cracked-machine/CirrusDspPedal/README.md

CirrusDspPedal

Required Kicad Hardware library: https://github.com/cracked-machine/KicadLibrary
