cracked-machine/CirrusDspPedal/CirrusDspPedal/docs/Cirrus5343Packet.png

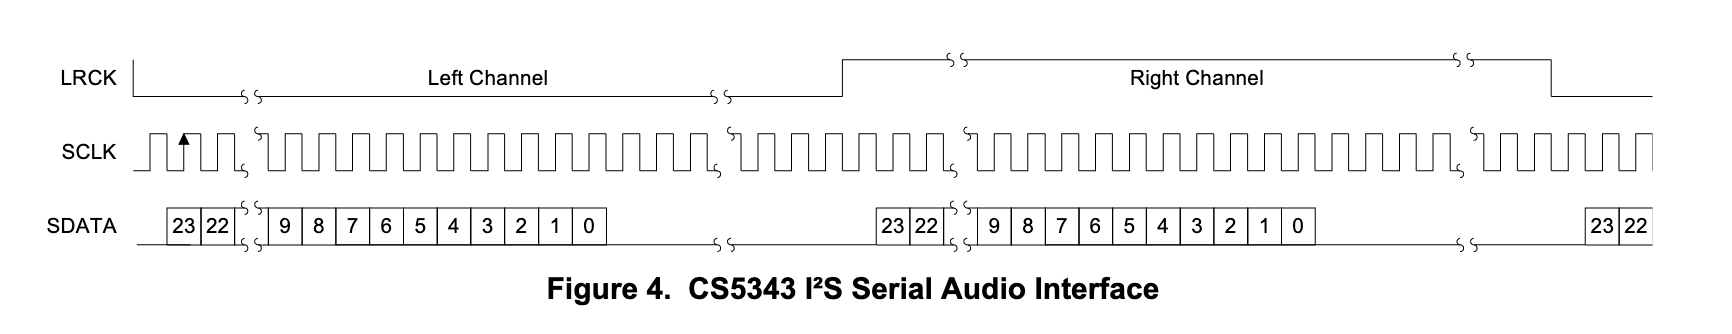
CirrusDspPedal/docs/Cirrus5343Packet.png
