cracked-machine/CirrusDspPedal/CirrusDspPedal/docs/DSPGuitarPedalF405_SystemBlockDiagram.png

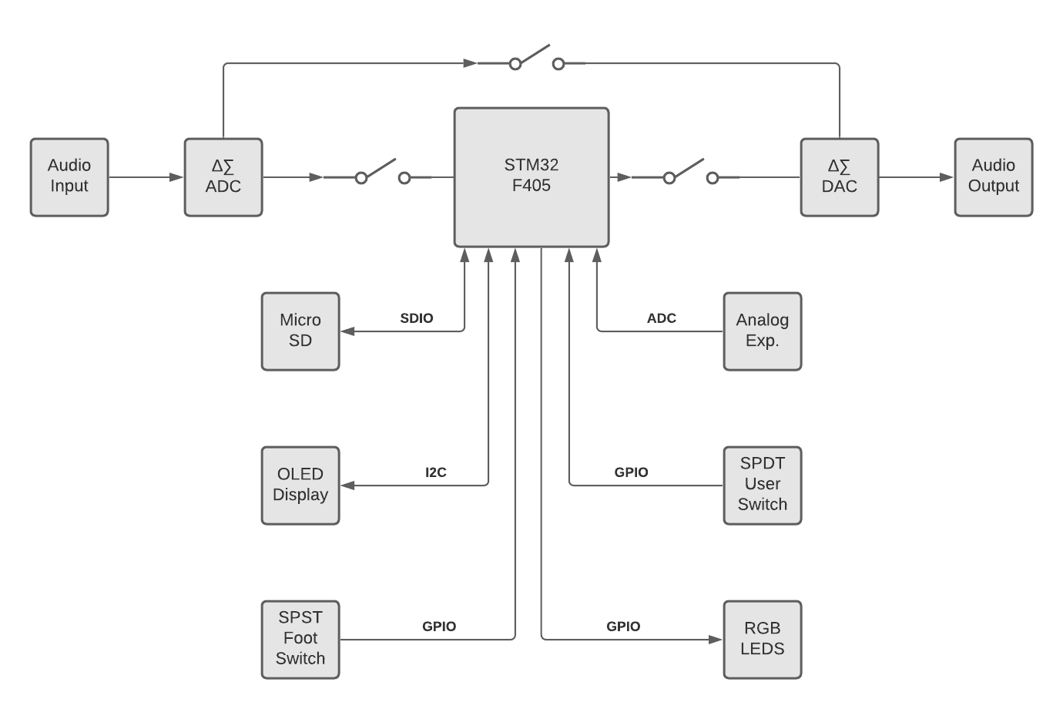
CirrusDspPedal/docs/DSPGuitarPedalF405_SystemBlockDiagram.png
