cracked-machine/CirrusDspPedal/CirrusDspPedal/docs/F405_I2S_24Bit.png

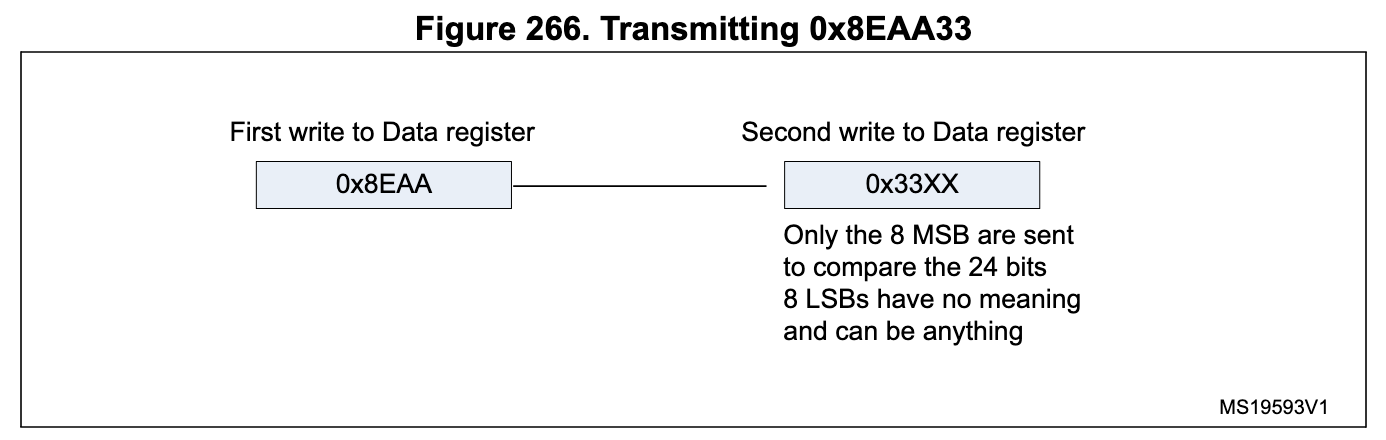
CirrusDspPedal/docs/F405_I2S_24Bit.png
