cracked-machine/CirrusDspPedal/CirrusDspPedal/docs/I2S_F32DoubleBuffer.png

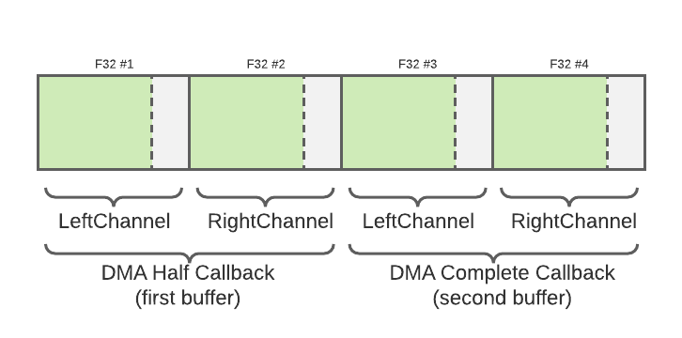
CirrusDspPedal/docs/I2S_F32DoubleBuffer.png
