cracked-machine/CirrusDspPedal/CirrusDspPedal/docs/I2S_PreparingRxData.png

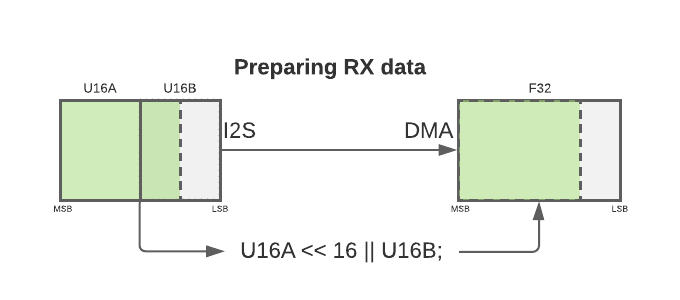
CirrusDspPedal/docs/I2S_PreparingRxData.png
