cracked-machine/CirrusDspPedal/CirrusDspPedal/docs/I2S_PreparingTxData.png

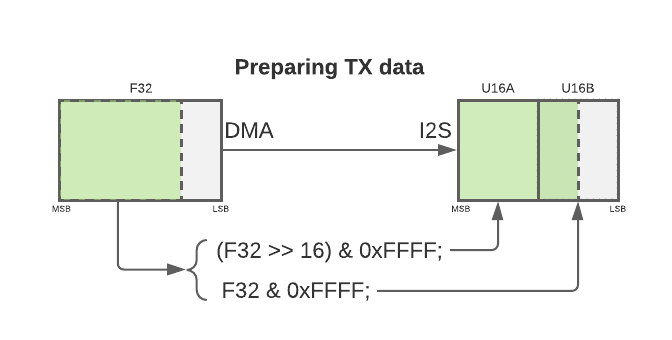
CirrusDspPedal/docs/I2S_PreparingTxData.png
