cracked-machine/CirrusDspPedal/CirrusDspPedal_FrontPanel/3d/M2012SS1W03.stp

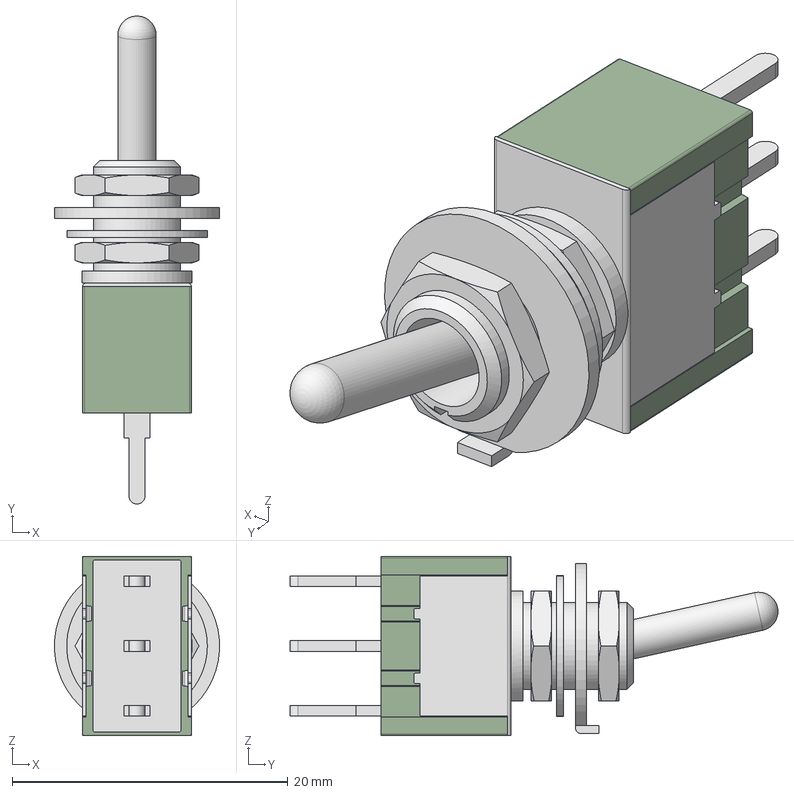
[picture p7: CAD file, 2020-11-12]
CirrusDspPedal_FrontPanel/3d/M2012SS1W03.stp
12.0 x 35.4 x 13.0 mm
_M20121SS1W03-switch
_M201S1M201-bushing
_AT513H x 2
_AT507H
_AT509
_M201203-terminals
_M20S-toggles
_M20S-caps
