cracked-machine/CirrusDspPedal/CirrusDspPedal_FrontPanel/3d/RK09D1130A1N/RK09D1130-F30.STEP

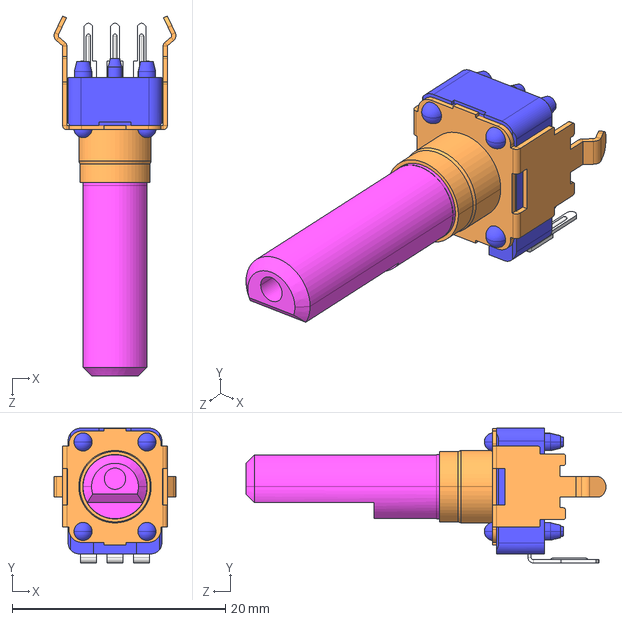
[picture p8: CAD file, 2020-10-19]
CirrusDspPedal_FrontPanel/3d/RK09D1130A1N/RK09D1130-F30.STEP
11.4 x 12.7 x 33.8 mm
