cracked-machine/CirrusDspPedal/CirrusDspPedal_FrontPanel/3d/rk09l1140a65/RK09L1140A65.STEP

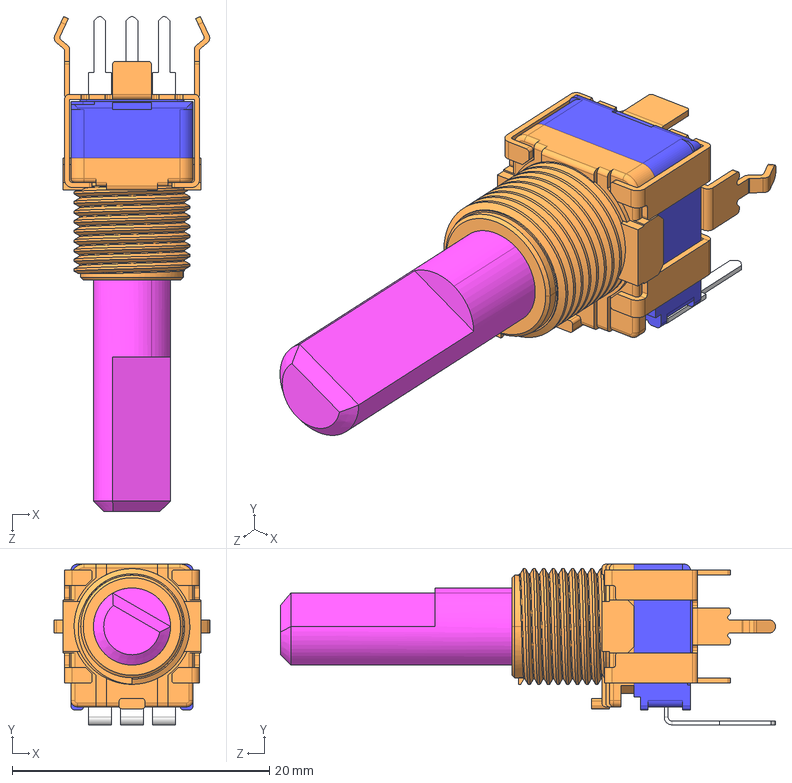
[picture p9: CAD file, 2020-10-19]
CirrusDspPedal_FrontPanel/3d/rk09l1140a65/RK09L1140A65.STEP
12.1 x 12.5 x 38.5 mm
