cracked-machine/CirrusDspPedal/CirrusDspPedal_FrontPanel/3d/pec11r-4x20f-sxxxx.stp

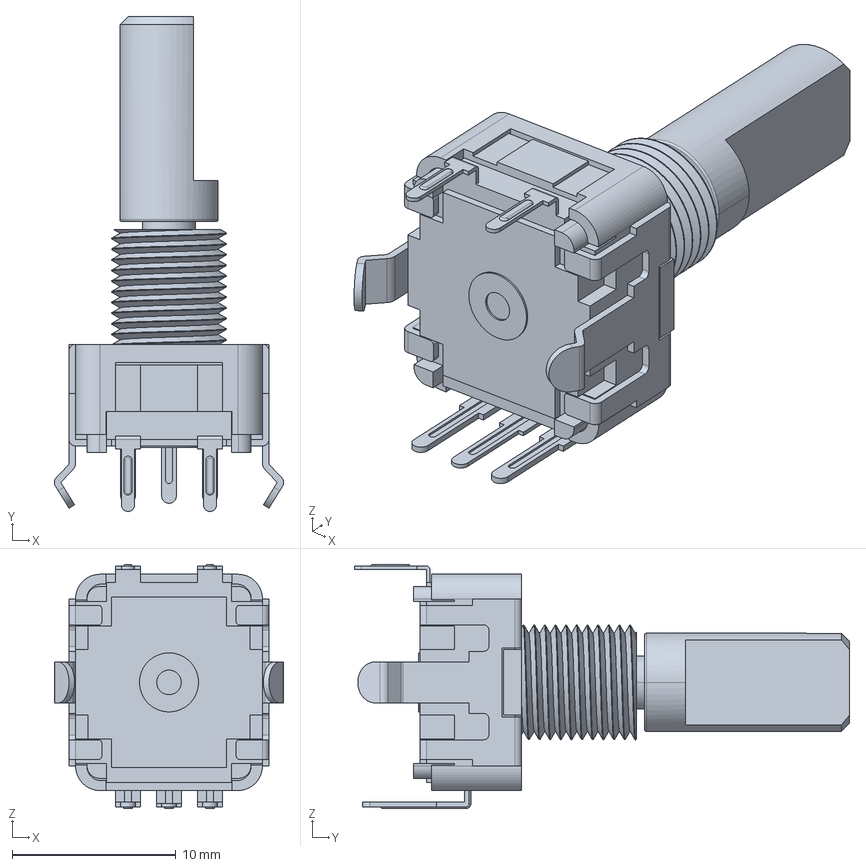
[picture p10: CAD file, 2020-11-12]
CirrusDspPedal_FrontPanel/3d/pec11r-4x20f-sxxxx.stp
14.0 x 30.2 x 14.9 mm
