cracked-machine/CirrusDspPedal/CirrusDspPedal_FrontPanel/3d/pec11r-4x30f-sxxxx.stp

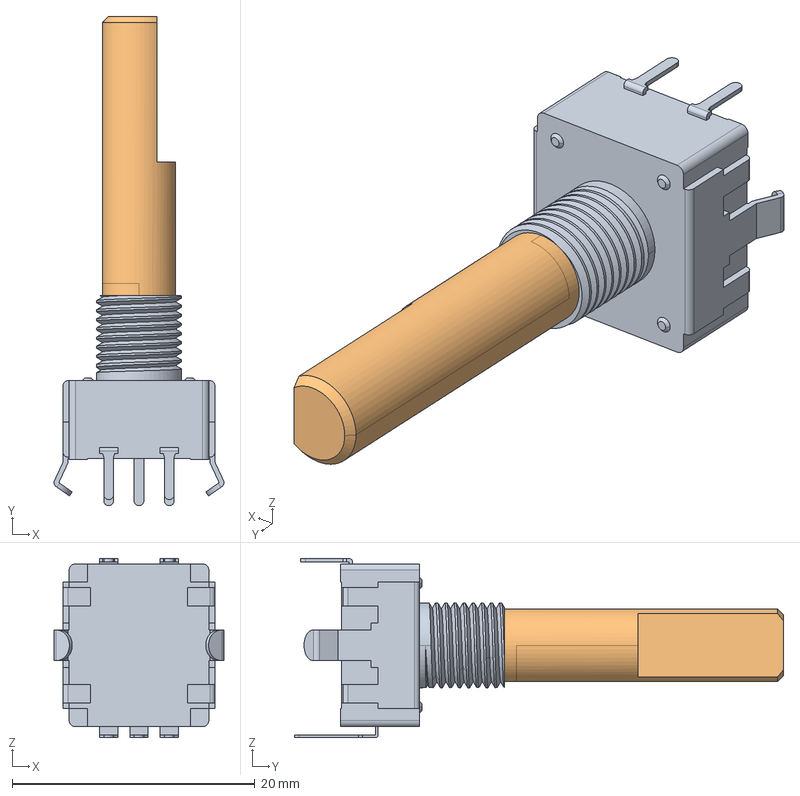
[picture p11: CAD file, 2020-11-12]
CirrusDspPedal_FrontPanel/3d/pec11r-4x30f-sxxxx.stp
14.0 x 40.3 x 14.8 mm
