cracked-machine/CirrusDspPedal/CirrusDspPedal_FrontPanel/3d/CUI_PJ-102A.STEP

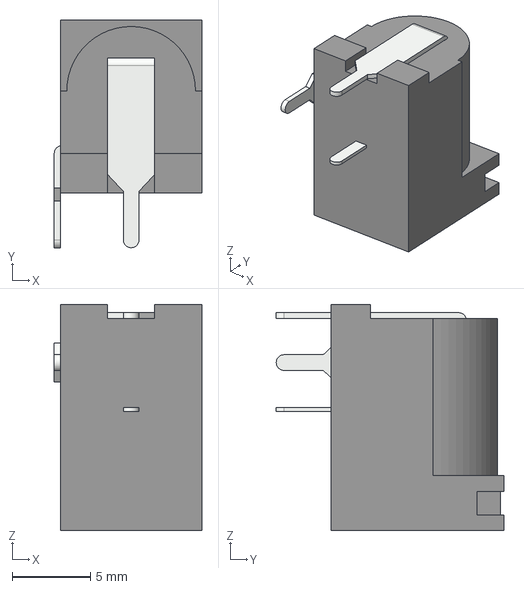
[picture p12: CAD file, 2020-11-12]
CirrusDspPedal_FrontPanel/3d/CUI_PJ-102A.STEP
9.40 x 14.5 x 14.4 mm
