cracked-machine/CirrusDspPedal/CirrusDspPedal_FrontPanel/3d/nrj4hf-2.stp

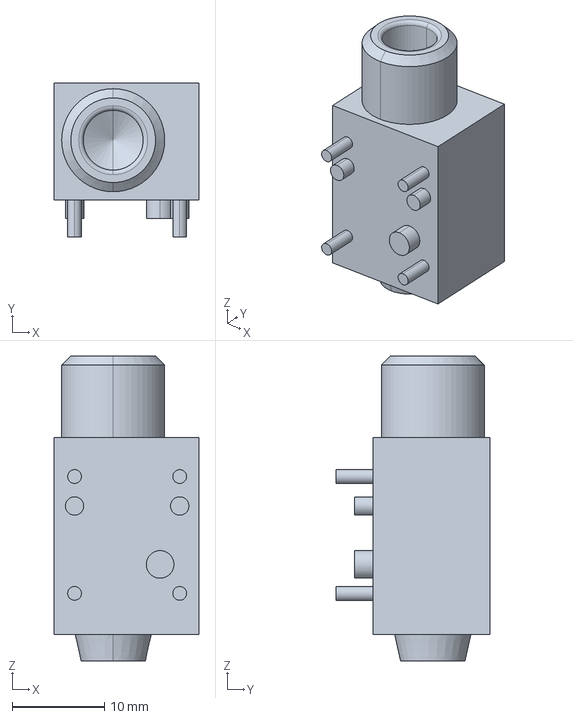
[picture p13: CAD file, 2020-10-19]
CirrusDspPedal_FrontPanel/3d/nrj4hf-2.stp
15.8 x 16.7 x 33.1 mm
