cracked-machine/CirrusDspPedal/CirrusDspPedal_FrontPanel/3d/c-3-643813-7-k-3d.stp

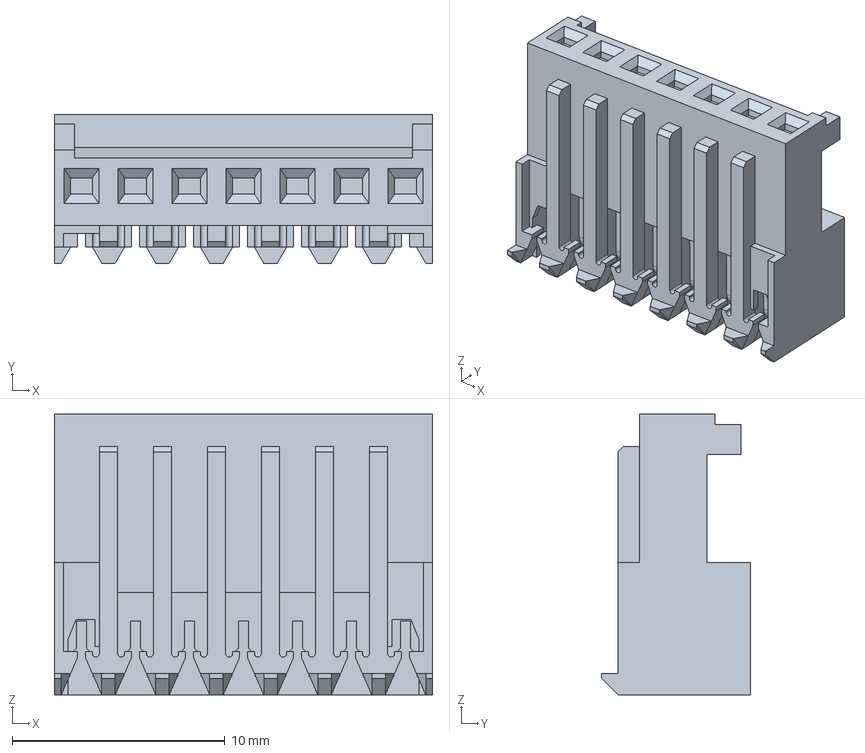
[picture p14: CAD file, 2020-10-18]
CirrusDspPedal_FrontPanel/3d/c-3-643813-7-k-3d.stp
17.8 x 6.98 x 13.2 mm
