cracked-machine/CirrusDspPedal/CirrusDspPedal_FrontPanel/3d/475710001.stp

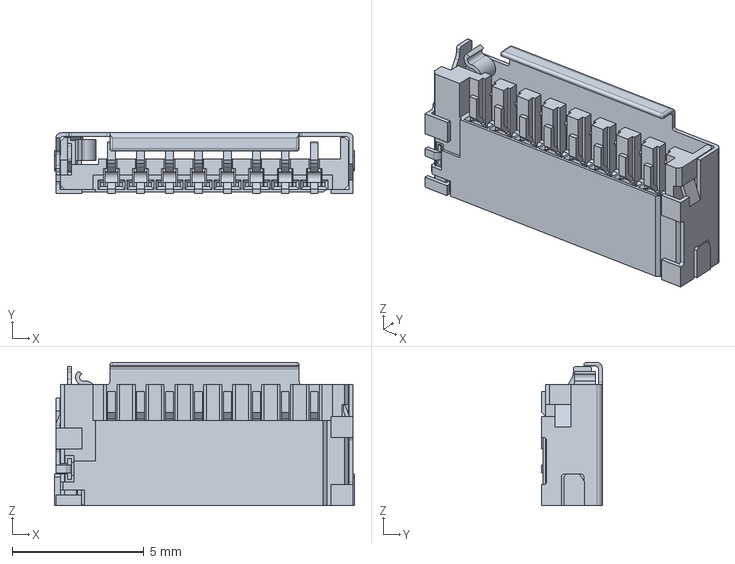
[picture p15: CAD file, 2020-11-10]
CirrusDspPedal_FrontPanel/3d/475710001.stp
11.4 x 2.30 x 5.45 mm
