cracked-machine/CirrusDspPedal/CirrusDspPedal_FrontPanel/ExpInput.sch

## KiCad design CirrusDspPedal_FrontPanel/ExpInput.sch (2020-10-12)

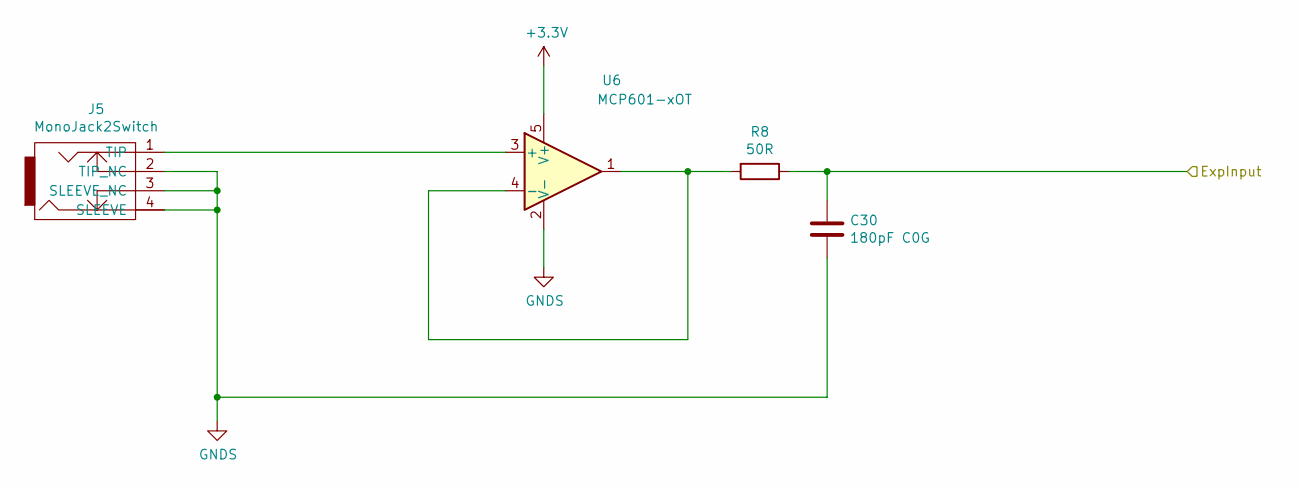
[picture p16: schematic ExpInput.sch]

Parts:
C30: 180pF C0G; C_0805_2012Metric_Pad1.15x1.40mm_HandSolder
J5: MonoJack2Switch; NRJxHx_NOTAB
R8: 50R; R_0805_2012Metric_Pad1.15x1.40mm_HandSolder
U6: MCP601-xOT; SOT-23-5

Connections:
+3.3V: U6.5 (V+)
ExpInput: C30.2, R8.1
GNDS: C30.1, J5.2 (TIP_NC), J5.3 (SLEEVE_NC), J5.4 (SLEEVE), U6.2 (V-)
unnamed: J5.1 (TIP), U6.3 (+)
unnamed: R8.2, U6.1, U6.4 (-)
