cracked-machine/CirrusDspPedal/CirrusDspPedal_FrontPanel/ExtInput.sch

## KiCad design CirrusDspPedal_FrontPanel/ExtInput.sch (2020-11-10)

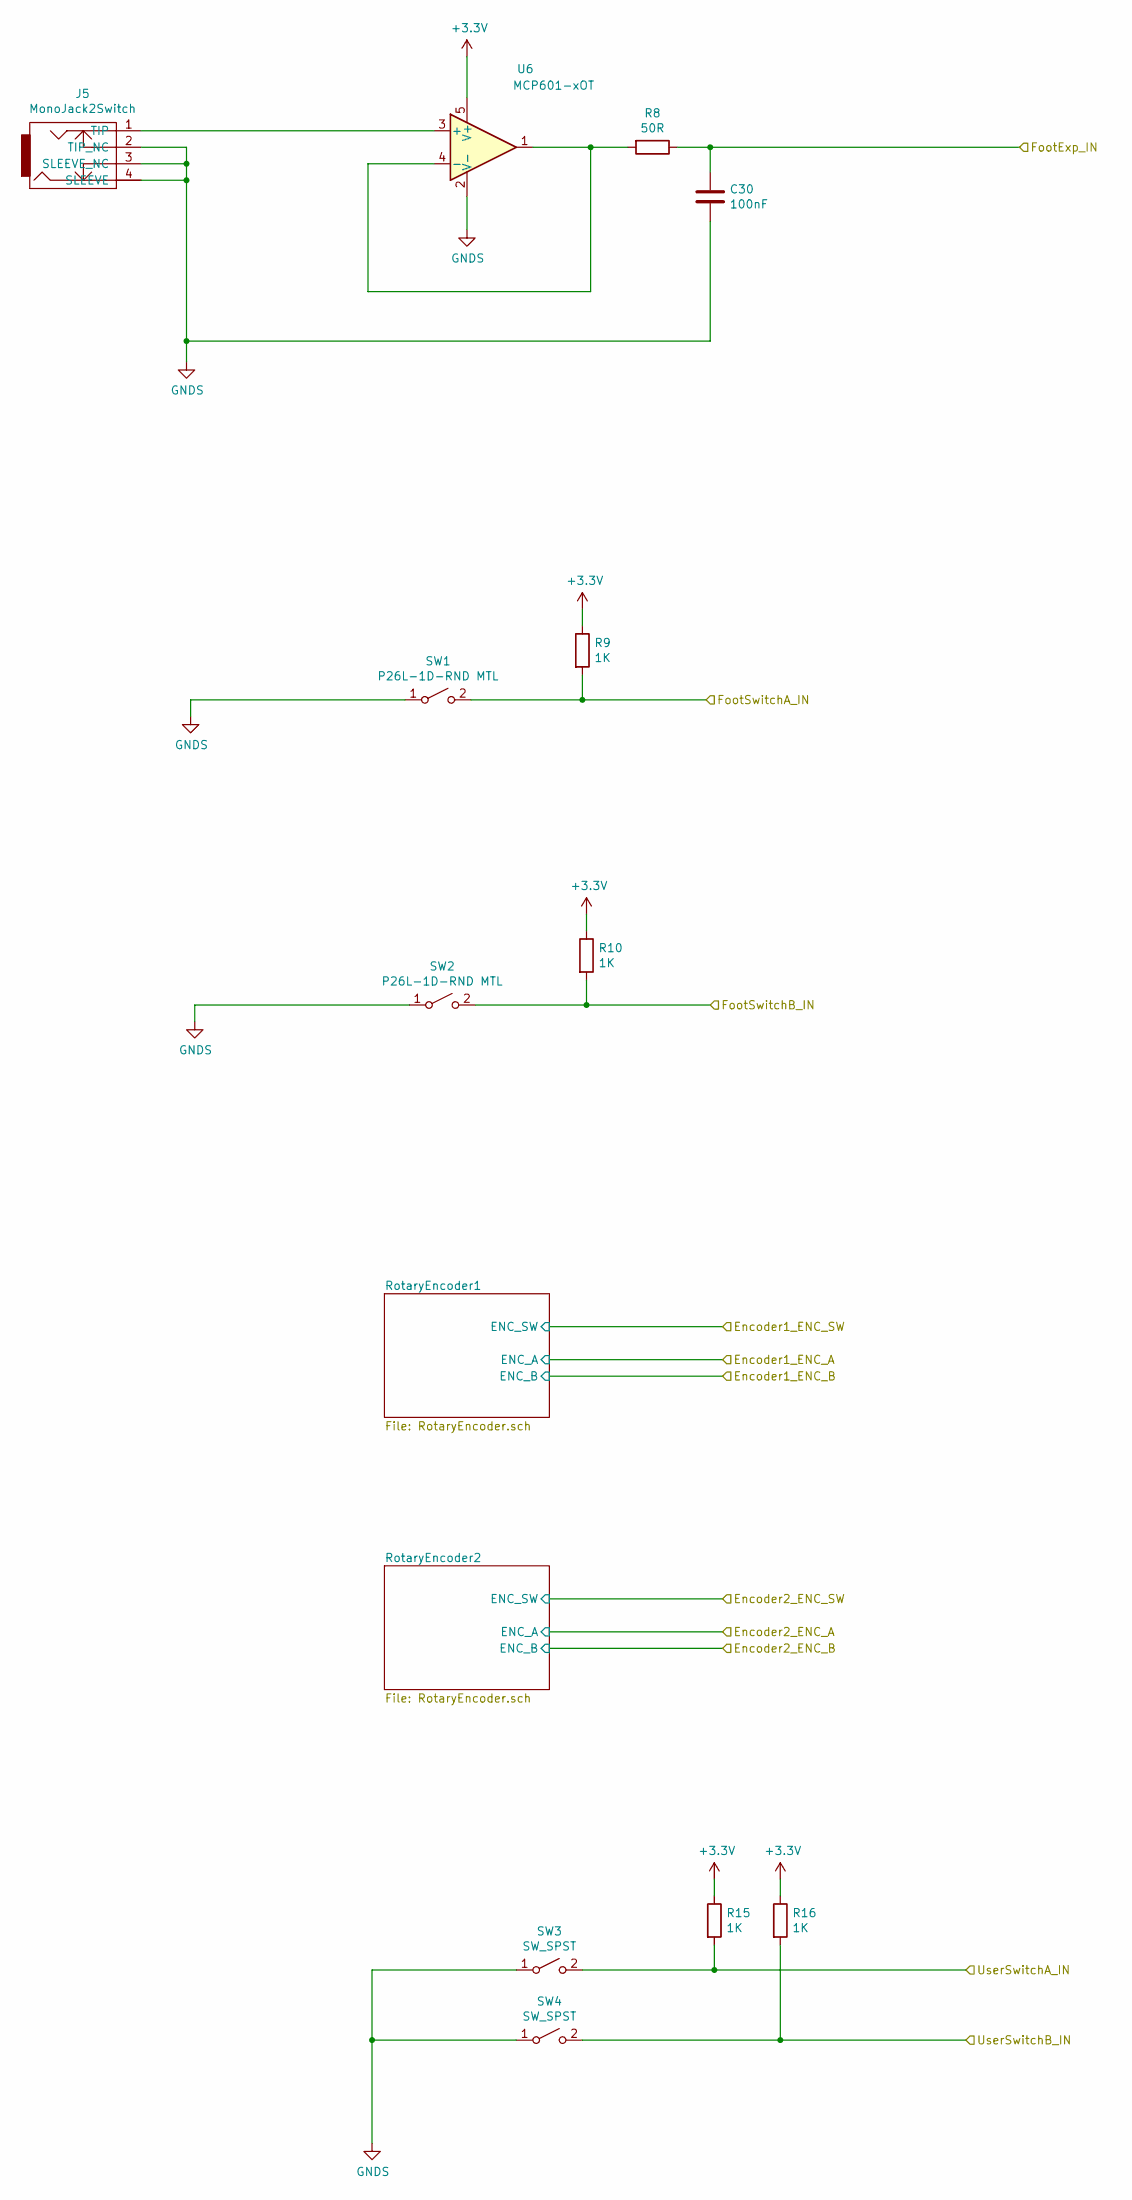
[picture p17: schematic ExtInput.sch]

Parts:
C30: 100nF; C_0805_2012Metric_Pad1.15x1.40mm_HandSolder
J5: MonoJack2Switch; NRJxHx_NOTAB
R8: 50R; R_0805_2012Metric_Pad1.15x1.40mm_HandSolder
R9, R10, R15, R16: 1K; R_0805_2012Metric_Pad1.15x1.40mm_HandSolder
SW1, SW2: P26L-1D-RND MTL; PinSocket_1x02_P2.54mm_Vertical
SW3, SW4: SW_SPST; SW_SPDT_W6.86MM_L12.7MM_P4.8MM_D2MM
U6: MCP601-xOT; SOT-23-5

Connections:
+3.3V: R9.1, R10.1, R15.1, R16.1, U6.5 (V+)
FootExp_IN: C30.2, R8.1
FootSwitchA_IN: R9.2, SW1.2 (B)
FootSwitchB_IN: R10.2, SW2.2 (B)
GNDS: C30.1, J5.2 (TIP_NC), J5.3 (SLEEVE_NC), J5.4 (SLEEVE), SW1.1 (A), SW2.1 (A), SW3.1 (A), SW4.1 (A), U6.2 (V-)
unnamed: J5.1 (TIP), U6.3 (+)
unnamed: R8.2, U6.1, U6.4 (-)
UserSwitchA_IN: R15.2, SW3.2 (B)
UserSwitchB_IN: R16.2, SW4.2 (B)
