cracked-machine/CirrusDspPedal/CirrusDspPedal_FrontPanel/InputSignal.sch

## KiCad design CirrusDspPedal_FrontPanel/InputSignal.sch (2020-11-12)

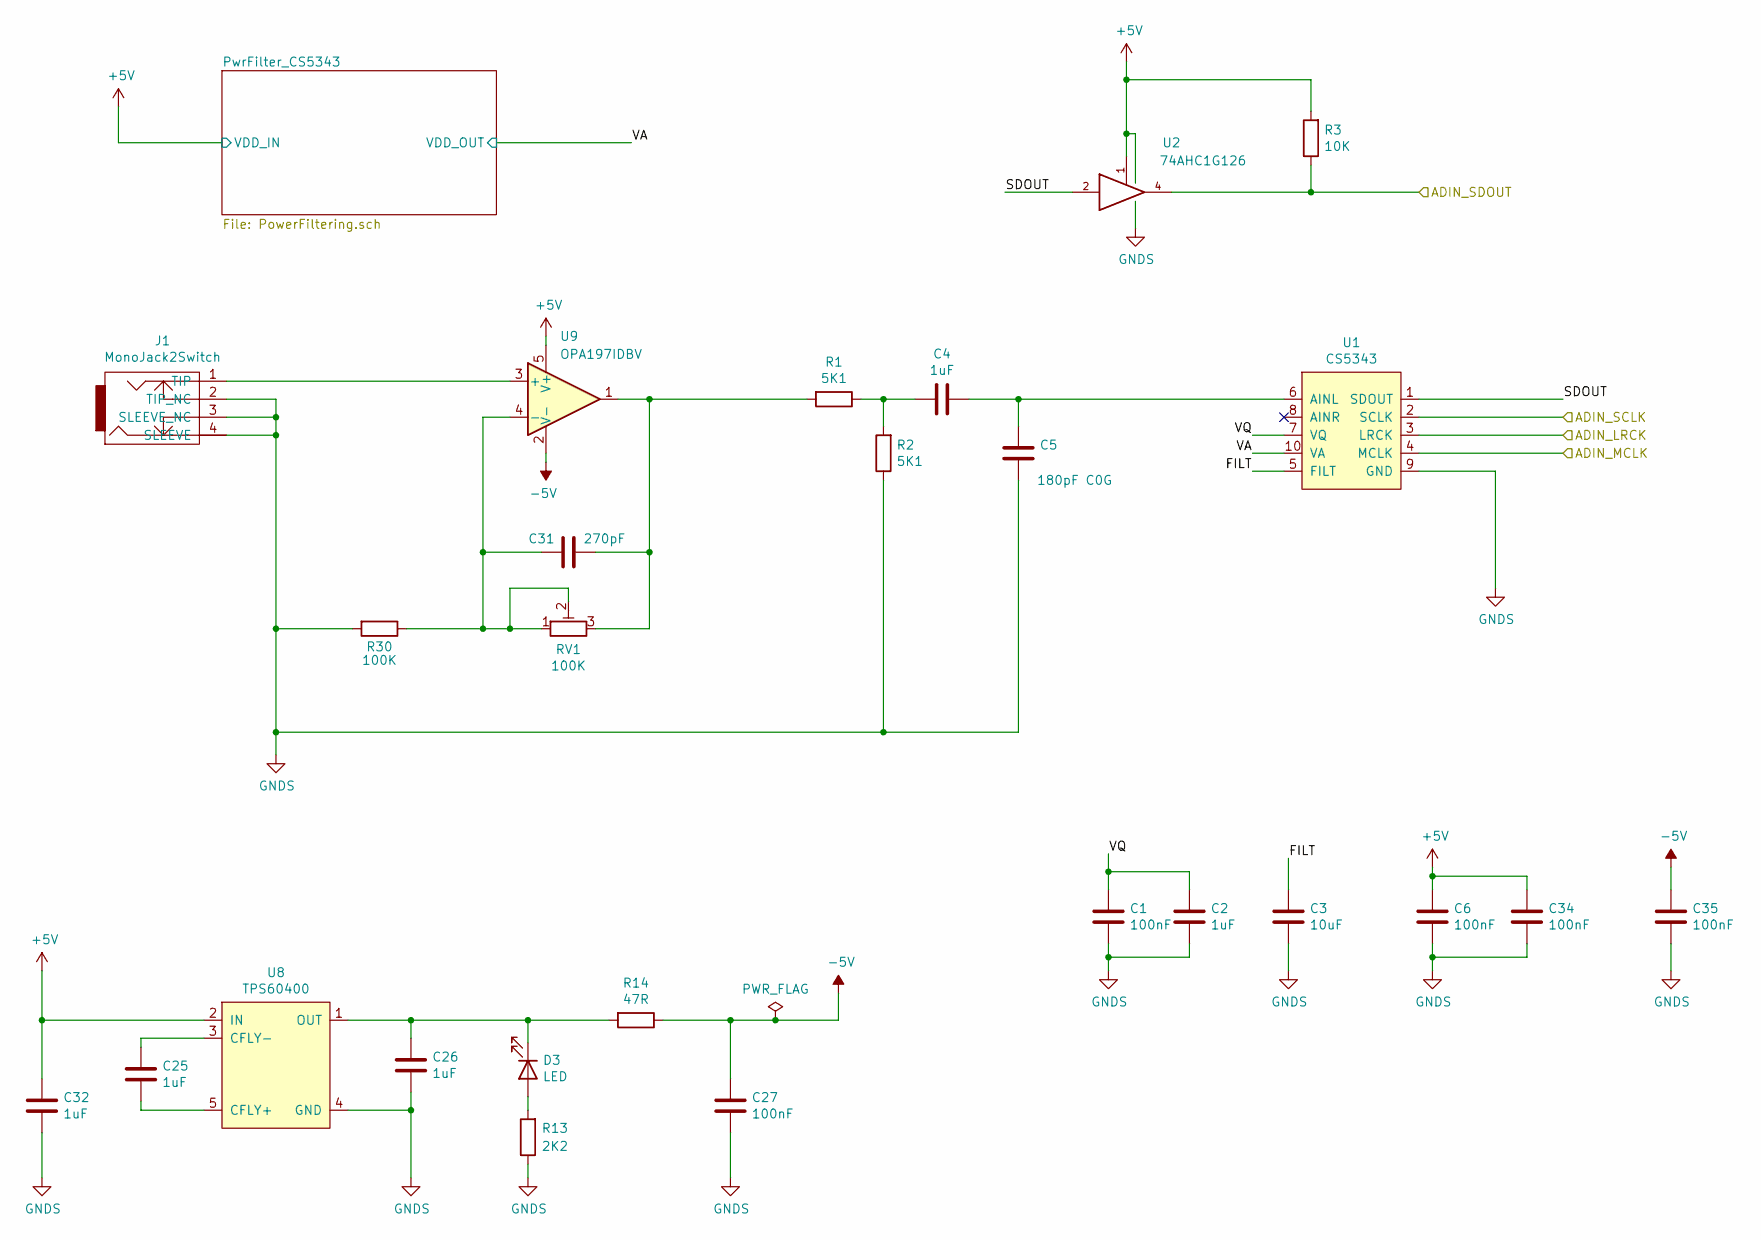
[picture p18: schematic InputSignal.sch]

Parts:
C1, C6: 100nF; C_0805_2012Metric_Pad1.15x1.40mm_HandSolder
C2, C4: 1uF; C_0805_2012Metric_Pad1.15x1.40mm_HandSolder
C3: 10uF; C_0805_2012Metric_Pad1.15x1.40mm_HandSolder
C5: 180pF C0G; C_0805_2012Metric_Pad1.15x1.40mm_HandSolder
C25, C26, C32: 1uF; C_0805_2012Metric_Pad1.18x1.45mm_HandSolder
C27, C34, C35: 100nF; C_0805_2012Metric_Pad1.18x1.45mm_HandSolder
C31: 270pF; C_0805_2012Metric_Pad1.18x1.45mm_HandSolder
D3: LED; LED_0805_2012Metric_Pad1.15x1.40mm_HandSolder
J1: MonoJack2Switch; NRJxHx_NOTAB
R1, R2: 5K1; R_0805_2012Metric_Pad1.15x1.40mm_HandSolder
R3: 10K; R_0805_2012Metric_Pad1.15x1.40mm_HandSolder
R13: 2K2; R_0805_2012Metric_Pad1.20x1.40mm_HandSolder
R14: 47R; R_0805_2012Metric_Pad1.20x1.40mm_HandSolder
R30: 100K; R_0805_2012Metric_Pad1.20x1.40mm_HandSolder
RV1: 100K; Potentiometer_Bourns_3314J_Vertical
U1: CS5343; TSSOP-10_3x3mm_P0.5mm
U2: 74AHC1G126; SOT-23-5_HandSoldering
U8: TPS60400; SOT-23-5_HandSoldering
U9: OPA197IDBV; SOT-23-5

Connections:
+5V: C6.1, C32.1, C34.1, R3.2, U2.1, U2.5 (VCC), U8.2 (IN), U9.5 (V+)
-5V: C27.1, C35.1, R14.1, U9.2 (V-)
ADIN_LRCK: U1.3 (LRCK)
ADIN_MCLK: U1.4 (MCLK)
ADIN_SCLK: U1.2 (SCLK)
ADIN_SDOUT: R3.1, U2.4
FILT: C3.1, U1.5 (FILT)
GNDS: C1.2, C2.2, C3.2, C5.1, C6.2, C26.2, C27.2, C32.2, C34.2, C35.2, J1.2 (TIP_NC), J1.3 (SLEEVE_NC), J1.4 (SLEEVE), R2.1, R13.1, R30.2, U1.9 (GND), U2.3 (GND), U8.4 (GND)
unnamed: C4.1, C5.2, U1.6 (AINL)
unnamed: C4.2, R1.1, R2.2
unnamed: C25.1, U8.3 (CFLY-)
unnamed: C25.2, U8.5 (CFLY+)
unnamed: C26.1, D3.1 (K), R14.2, U8.1 (OUT)
unnamed: C31.1, R1.2, RV1.3, U9.1
unnamed: C31.2, R30.1, RV1.1, RV1.2, U9.4 (-)
unnamed: D3.2 (A), R13.2
unnamed: J1.1 (TIP), U9.3 (+)
SDOUT: U1.1 (SDOUT), U2.2
VA: U1.10 (VA)
VQ: C1.1, C2.1, U1.7 (VQ)
