cracked-machine/CirrusDspPedal/CirrusDspPedal_FrontPanel/MicroSD.sch

## KiCad design CirrusDspPedal_FrontPanel/MicroSD.sch (2020-11-10)

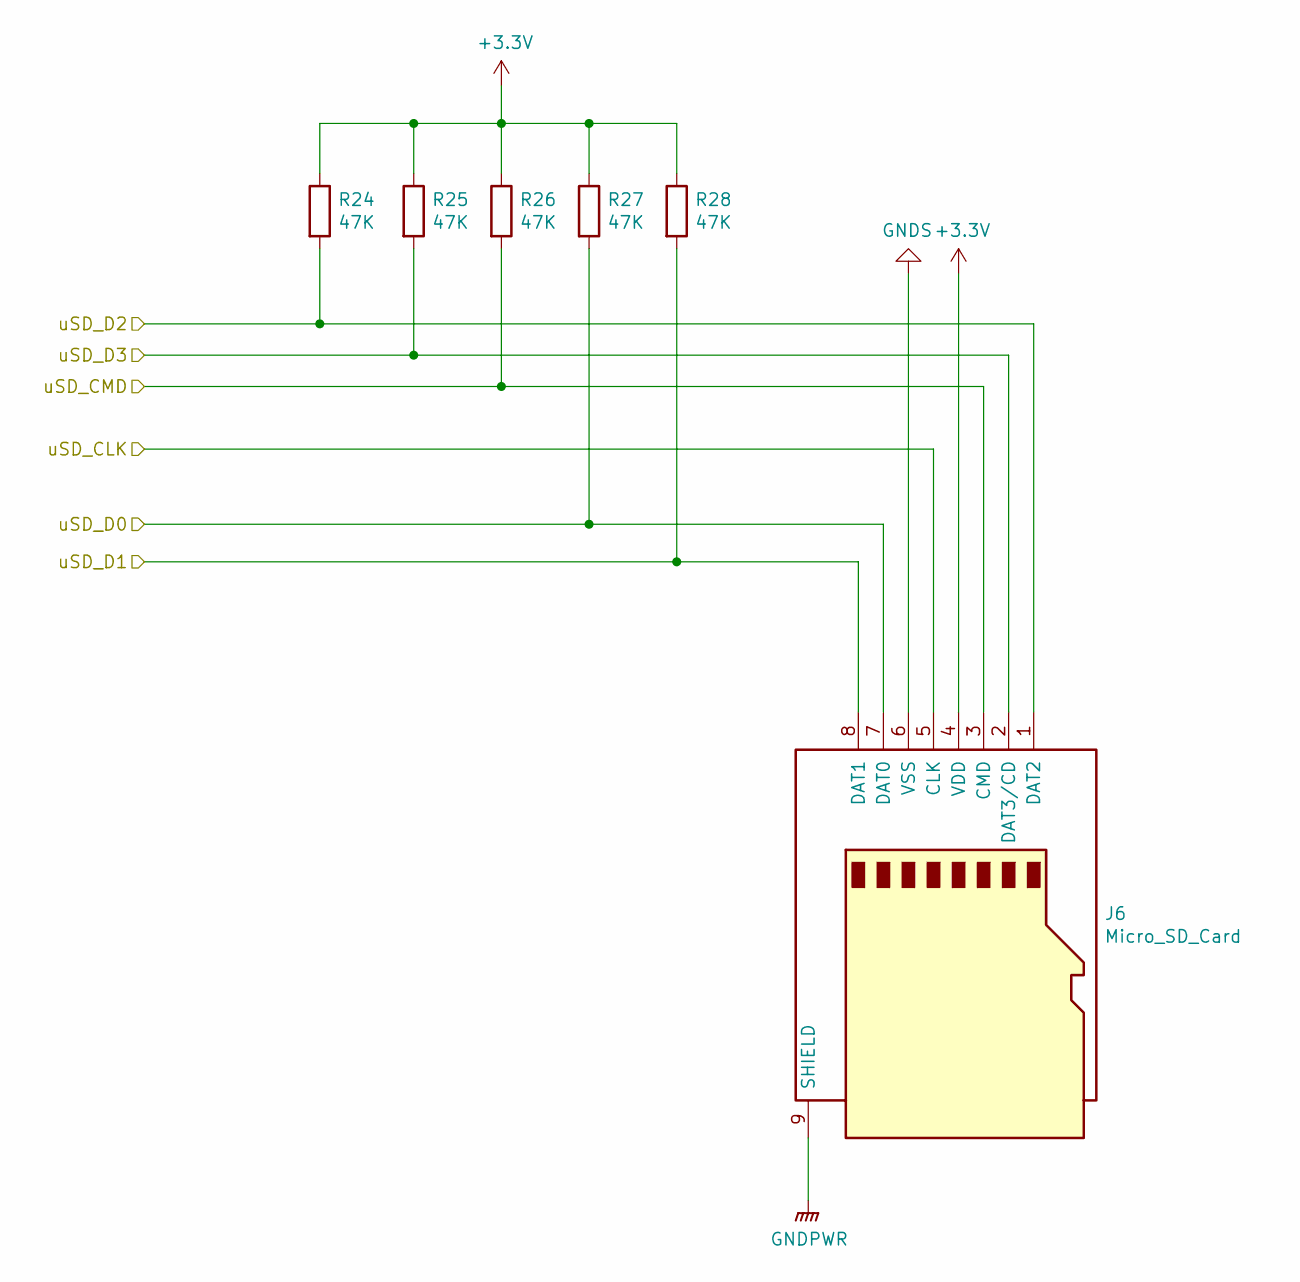
[picture p19: schematic MicroSD.sch]

Parts:
J6: Micro_SD_Card; Molex_SDIO_475710001
R24, R25, R26, R27, R28: 47K; R_0805_2012Metric_Pad1.15x1.40mm_HandSolder

Connections:
+3.3V: J6.4 (VDD), R24.1, R25.1, R26.1, R27.1, R28.1
GNDPWR: J6.9 (SHIELD)
GNDS: J6.6 (VSS)
uSD_CLK: J6.5 (CLK)
uSD_CMD: J6.3 (CMD), R26.2
uSD_D0: J6.7 (DAT0), R27.2
uSD_D1: J6.8 (DAT1), R28.2
uSD_D2: J6.1 (DAT2), R24.2
uSD_D3: J6.2 (DAT3/CD), R25.2
