cracked-machine/CirrusDspPedal/CirrusDspPedal_FrontPanel/OutputSignal.sch

## KiCad design CirrusDspPedal_FrontPanel/OutputSignal.sch (2020-11-10)

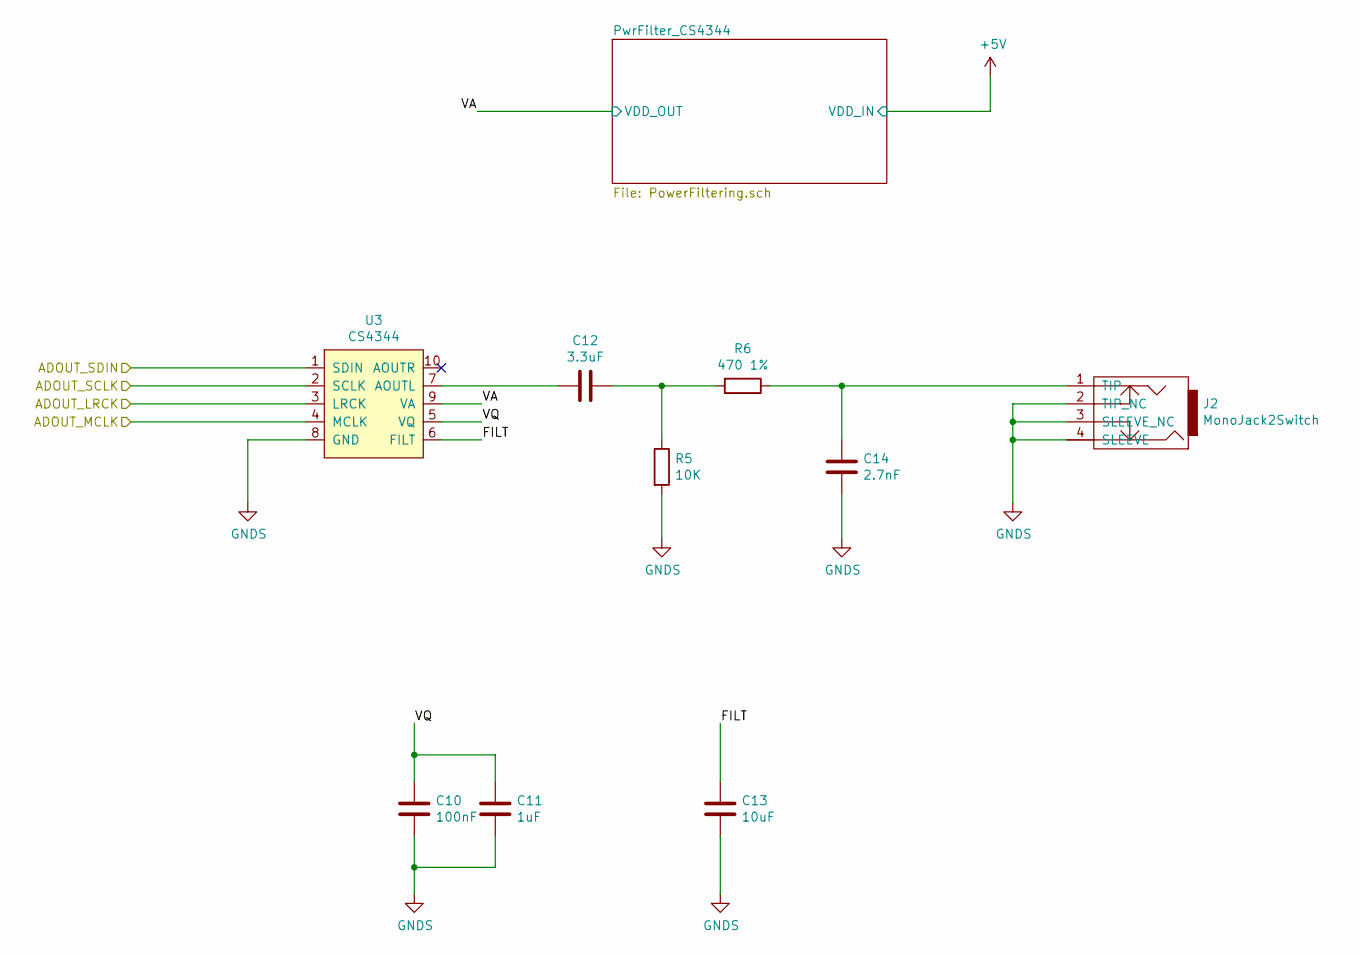
[picture p20: schematic OutputSignal.sch]

Parts:
C10: 100nF; C_0805_2012Metric_Pad1.15x1.40mm_HandSolder
C11: 1uF; C_0805_2012Metric_Pad1.15x1.40mm_HandSolder
C12: 3.3uF; C_0805_2012Metric_Pad1.15x1.40mm_HandSolder
C13: 10uF; C_0805_2012Metric_Pad1.15x1.40mm_HandSolder
C14: 2.7nF; C_0805_2012Metric_Pad1.15x1.40mm_HandSolder
J2: MonoJack2Switch; NRJxHx_NOTAB
R5: 10K; R_0805_2012Metric_Pad1.15x1.40mm_HandSolder
R6: 470 1%; R_0805_2012Metric_Pad1.15x1.40mm_HandSolder
U3: CS4344; TSSOP-10_3x3mm_P0.5mm

Connections:
ADOUT_LRCK: U3.3 (LRCK)
ADOUT_MCLK: U3.4 (MCLK)
ADOUT_SCLK: U3.2 (SCLK)
ADOUT_SDIN: U3.1 (SDIN)
FILT: C13.1, U3.6 (FILT)
GNDS: C10.2, C11.2, C13.2, C14.1, J2.2 (TIP_NC), J2.3 (SLEEVE_NC), J2.4 (SLEEVE), R5.2, U3.8 (GND)
unnamed: C12.1, R5.1, R6.2
unnamed: C12.2, U3.7 (AOUTL)
unnamed: C14.2, J2.1 (TIP), R6.1
VA: U3.9 (VA)
VQ: C10.1, C11.1, U3.5 (VQ)
