cracked-machine/CirrusDspPedal/CirrusDspPedal_FrontPanel/PSU.sch

## KiCad design CirrusDspPedal_FrontPanel/PSU.sch (2020-11-12)

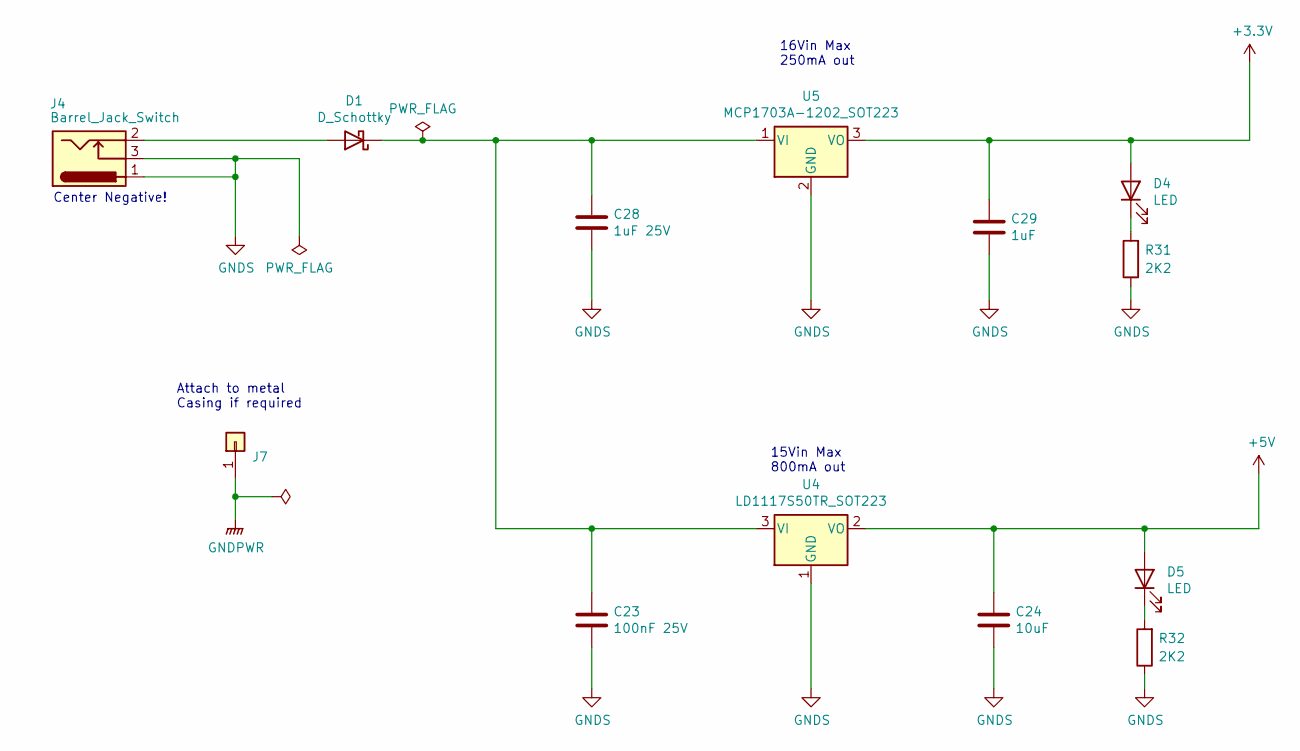
[picture p21: schematic PSU.sch]

Parts:
C23: 100nF 25V; C_1206_3216Metric_Pad1.42x1.75mm_HandSolder
C24: 10uF; C_1206_3216Metric_Pad1.42x1.75mm_HandSolder
C28: 1uF 25V; C_1206_3216Metric_Pad1.42x1.75mm_HandSolder
C29: 1uF; C_1206_3216Metric_Pad1.42x1.75mm_HandSolder
D1: D_Schottky; D_SOD-123F
D4, D5: LED; LED_0805_2012Metric_Pad1.15x1.40mm_HandSolder
J4: Barrel_Jack_Switch; BarrelJack_Horizontal
J7: Conn_01x01; TestPoint_Pad_2.0x2.0mm
R31, R32: 2K2; R_0805_2012Metric_Pad1.20x1.40mm_HandSolder
U4: LD1117S50TR_SOT223; SOT-223-3_TabPin2
U5: MCP1703A-1202_SOT223; SOT-223-3_TabPin2

Connections:
+3.3V: C29.1, D4.2 (A), U5.3 (VO)
+5V: C24.1, D5.2 (A), U4.2 (VO)
GNDPWR: J7.1
GNDS: C23.2, C24.2, C28.2, C29.2, J4.1, J4.3, R31.1, R32.1, U4.1 (GND), U5.2 (GND)
unnamed: C23.1, C28.1, D1.1 (K), U4.3 (VI), U5.1 (VI)
unnamed: D1.2 (A), J4.2
unnamed: D4.1 (K), R31.2
unnamed: D5.1 (K), R32.2

Notes on the sheet:
Center Negative!
16Vin Max 250mA out
15Vin Max 800mA out
Attach to metal Casing if required
