cracked-machine/CirrusDspPedal/CirrusDspPedal_FrontPanel/PowerFiltering.sch

## KiCad design CirrusDspPedal_FrontPanel/PowerFiltering.sch (2020-11-10)

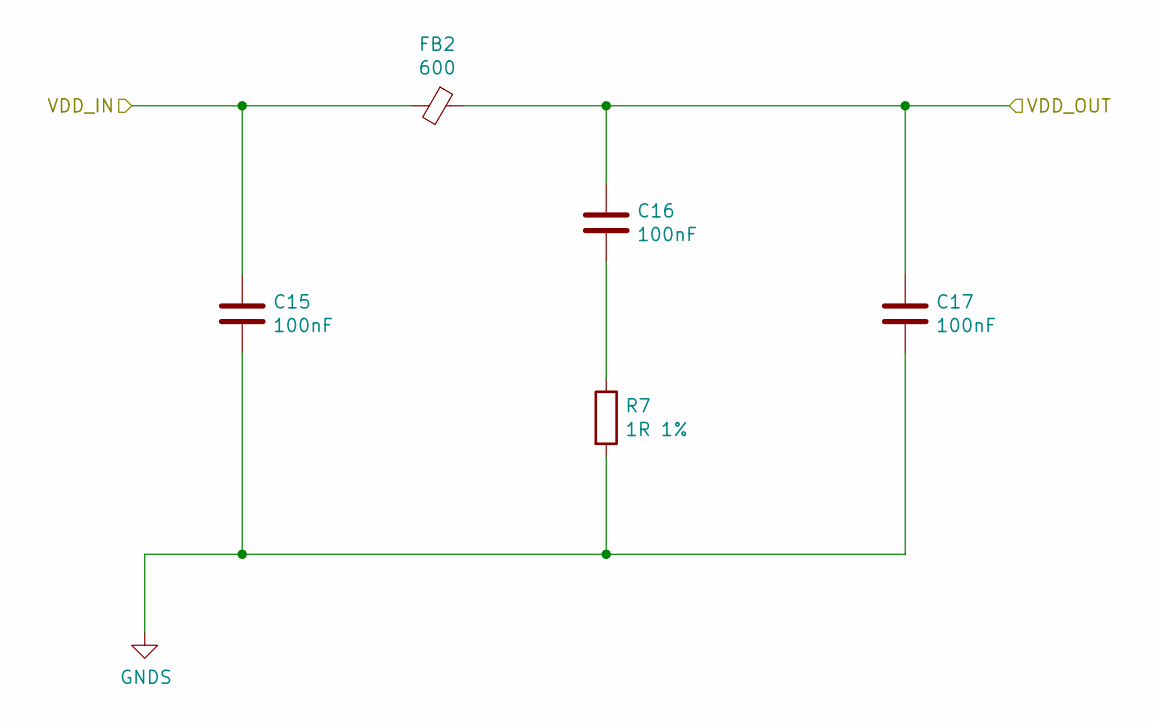
[picture p22: schematic PowerFiltering.sch]

Parts:
C7, C8, C9: 100nF; C_0805_2012Metric_Pad1.15x1.40mm_HandSolder
FB1: 600; L_0805_2012Metric_Pad1.15x1.40mm_HandSolder
R4: 1R 1%; R_0805_2012Metric_Pad1.15x1.40mm_HandSolder

Connections:
GNDS: C7.2, C9.2, R4.2
unnamed: C8.2, R4.1
VDD_IN: C7.1, FB1.2
VDD_OUT: C8.1, C9.1, FB1.1
