cracked-machine/CirrusDspPedal/CirrusDspPedal_FrontPanel/RotaryEncoder.sch

## KiCad design CirrusDspPedal_FrontPanel/RotaryEncoder.sch (2020-11-12)

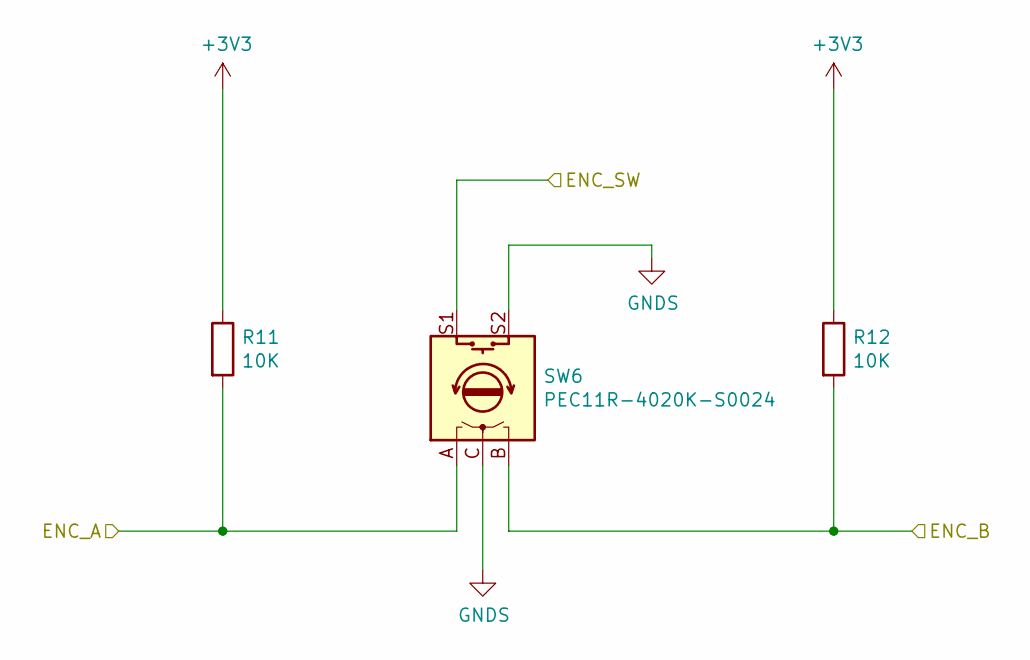
[picture p23: schematic RotaryEncoder.sch]

Parts:
R23, R29: 10K; R_0805_2012Metric_Pad1.20x1.40mm_HandSolder
SW5: PEC11R-4020K-S0024; RotaryEncoder_Alps_EC11E-Switch_Vertical_H20mm

Connections:
+3V3: R23.1, R29.1
ENC_A: R23.2, SW5.A
ENC_B: R29.2, SW5.B
ENC_SW: SW5.S1
GNDS: SW5.C, SW5.S2
