cracked-machine/CirrusDspPedal/CirrusDspPedal_FrontPanel/SignalProcessing.sch

## KiCad design CirrusDspPedal_FrontPanel/SignalProcessing.sch (2020-11-12)

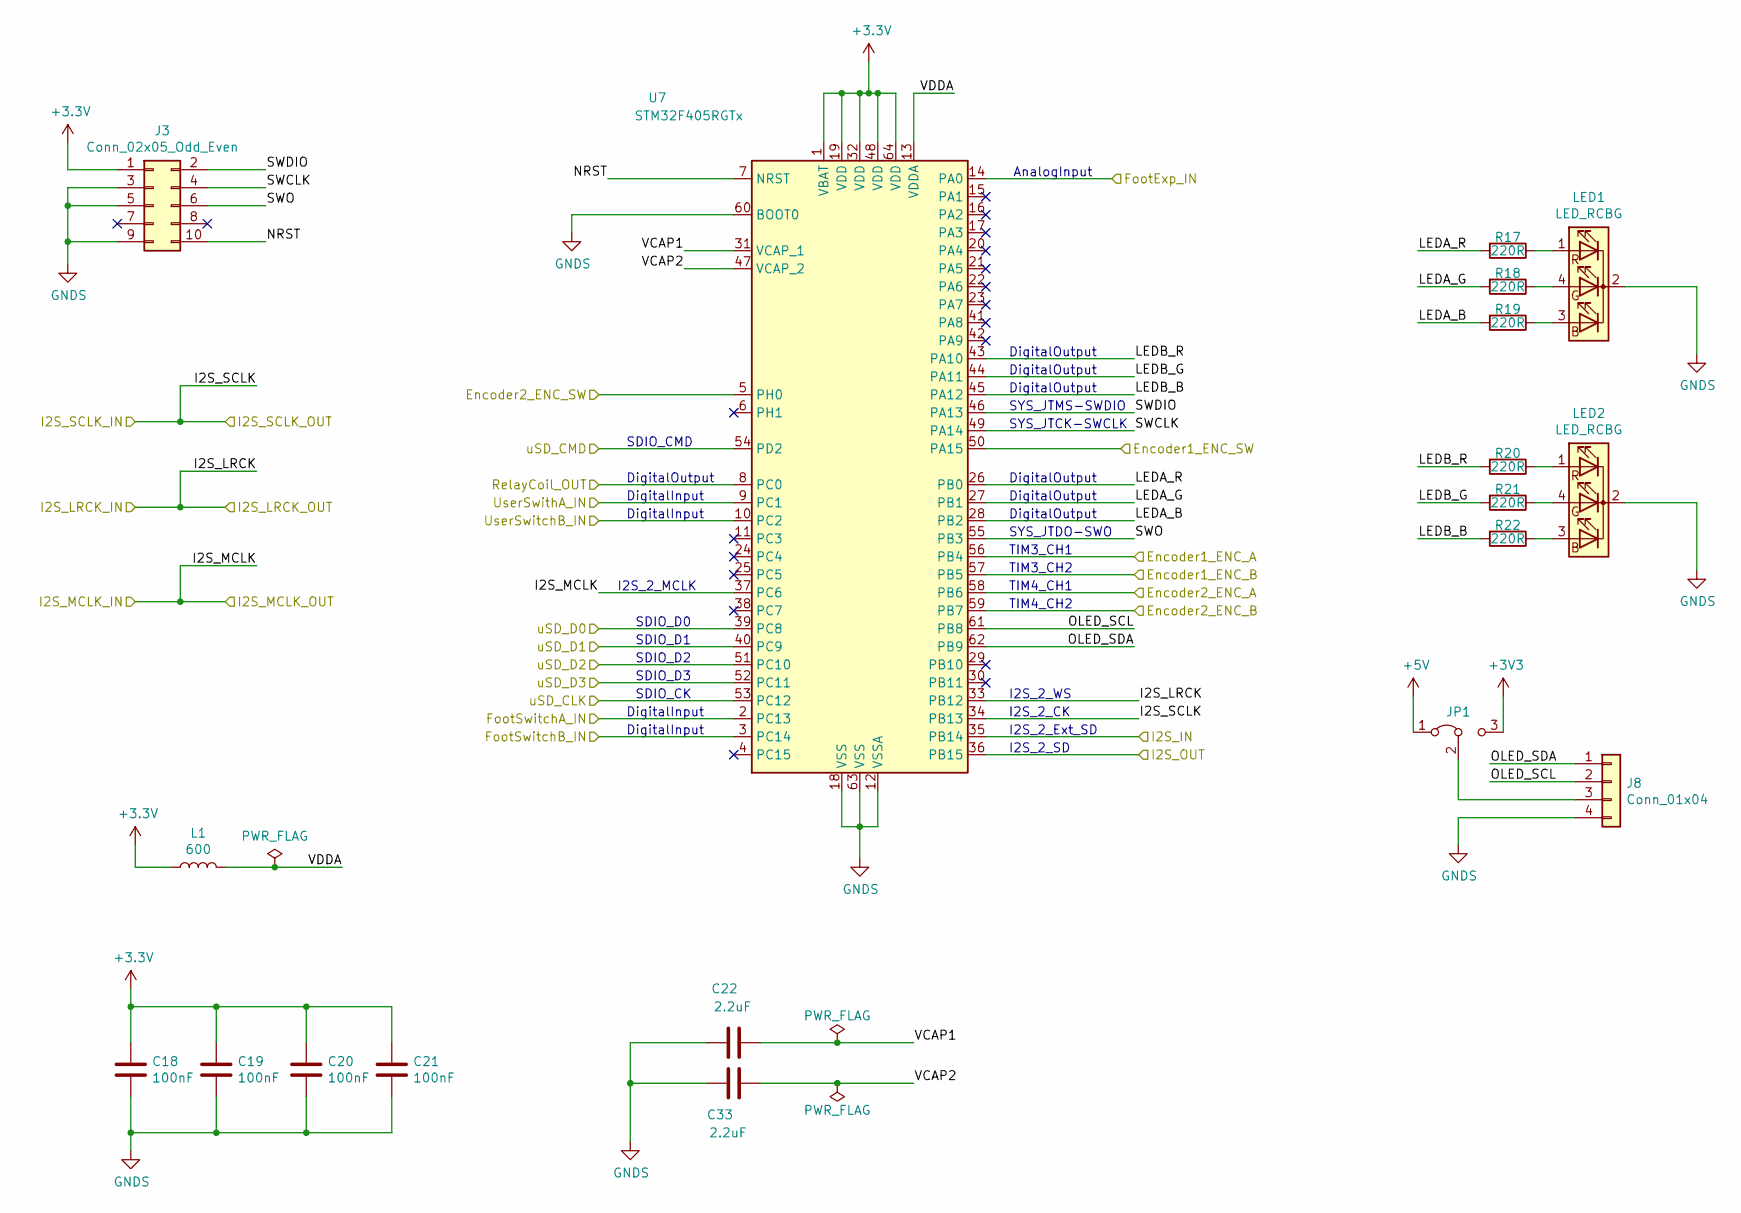
[picture p24: schematic SignalProcessing.sch]

Parts:
C18, C19, C20, C21: 100nF; C_0805_2012Metric_Pad1.15x1.40mm_HandSolder
C22, C33: 2.2uF; C_0805_2012Metric_Pad1.15x1.40mm_HandSolder
J3: Conn_02x05_Odd_Even; PinHeader_2x05_P1.27mm_Vertical_SMD
J8: Conn_01x04; Molex_KK-254_AE-6410-04A_1x04_P2.54mm_Vertical
JP1: Jumper_3_Bridged12; SolderJumper-3_P1.3mm_Bridged2Bar12_Pad1.0x1.5mm
L1: 600; L_0805_2012Metric_Pad1.15x1.40mm_HandSolder
LED1, LED2: LED_RCBG; LED_D5.0mm-4_RGB_Wide_Pins
R17, R18, R19, R20, R21, R22: 220R; R_0805_2012Metric_Pad1.15x1.40mm_HandSolder
U7: STM32F405RGTx; LQFP-64_10x10mm_P0.5mm

Connections:
+3.3V: C18.1, C19.1, C20.1, C21.1, J3.1, L1.1, U7.1 (VBAT), U7.19 (VDD), U7.32 (VDD), U7.48 (VDD), U7.64 (VDD)
+3V3: JP1.3 (B)
+5V: JP1.1 (A)
Encoder1_ENC_A: U7.56 (PB4)
Encoder1_ENC_B: U7.57 (PB5)
Encoder1_ENC_SW: U7.50 (PA15)
Encoder2_ENC_A: U7.58 (PB6)
Encoder2_ENC_B: U7.59 (PB7)
Encoder2_ENC_SW: U7.5 (PH0)
FootExp_IN: U7.14 (PA0)
FootSwitchA_IN: U7.2 (PC13)
FootSwitchB_IN: U7.3 (PC14)
GNDS: C18.2, C19.2, C20.2, C21.2, C22.1, C33.1, J3.3, J3.5, J3.9, J8.4, LED1.2 (K), LED2.2 (K), U7.12 (VSSA), U7.18 (VSS), U7.60 (BOOT0), U7.63 (VSS)
I2S_IN: U7.35 (PB14)
I2S_LRCK: U7.33 (PB12)
I2S_MCLK: U7.37 (PC6)
I2S_OUT: U7.36 (PB15)
I2S_SCLK: U7.34 (PB13)
LEDA_B: R19.2, U7.28 (PB2)
LEDA_G: R18.2, U7.27 (PB1)
LEDA_R: R17.2, U7.26 (PB0)
LEDB_B: R22.2, U7.45 (PA12)
LEDB_G: R21.2, U7.44 (PA11)
LEDB_R: R20.2, U7.43 (PA10)
NRST: J3.10, U7.7 (NRST)
unnamed: J8.3, JP1.2 (C)
unnamed: LED1.1 (RA), R17.1
unnamed: LED1.3 (BA), R19.1
unnamed: LED1.4 (GA), R18.1
unnamed: LED2.1 (RA), R20.1
unnamed: LED2.3 (BA), R22.1
unnamed: LED2.4 (GA), R21.1
OLED_SCL: J8.2, U7.61 (PB8)
OLED_SDA: J8.1, U7.62 (PB9)
RelayCoil_OUT: U7.8 (PC0)
SWCLK: J3.4, U7.49 (PA14)
SWDIO: J3.2, U7.46 (PA13)
SWO: J3.6, U7.55 (PB3)
UserSwitchB_IN: U7.10 (PC2)
UserSwithA_IN: U7.9 (PC1)
VCAP1: C22.2, U7.31 (VCAP_1)
VCAP2: C33.2, U7.47 (VCAP_2)
VDDA: L1.2, U7.13 (VDDA)
uSD_CLK: U7.53 (PC12)
uSD_CMD: U7.54 (PD2)
uSD_D0: U7.39 (PC8)
uSD_D1: U7.40 (PC9)
uSD_D2: U7.51 (PC10)
uSD_D3: U7.52 (PC11)

Notes on the sheet:
I2S_2_CK
I2S_2_MCLK
I2S_2_WS
I2S_2_Ext_SD
I2S_2_SD
DigitalOutput
DigitalInput
AnalogInput
SYS_JTDO-SWO
SYS_JTMS-SWDIO
SYS_JTCK-SWCLK
SDIO_D0
SDIO_D1
SDIO_D2
SDIO_D3
SDIO_CK
SDIO_CMD
TIM3_CH1
TIM3_CH2
TIM4_CH1
TIM4_CH2
