cracked-machine/CirrusDspPedal/CirrusDspPedal_FrontPanel/SignalRelay.sch

## KiCad design CirrusDspPedal_FrontPanel/SignalRelay.sch (2020-11-10)

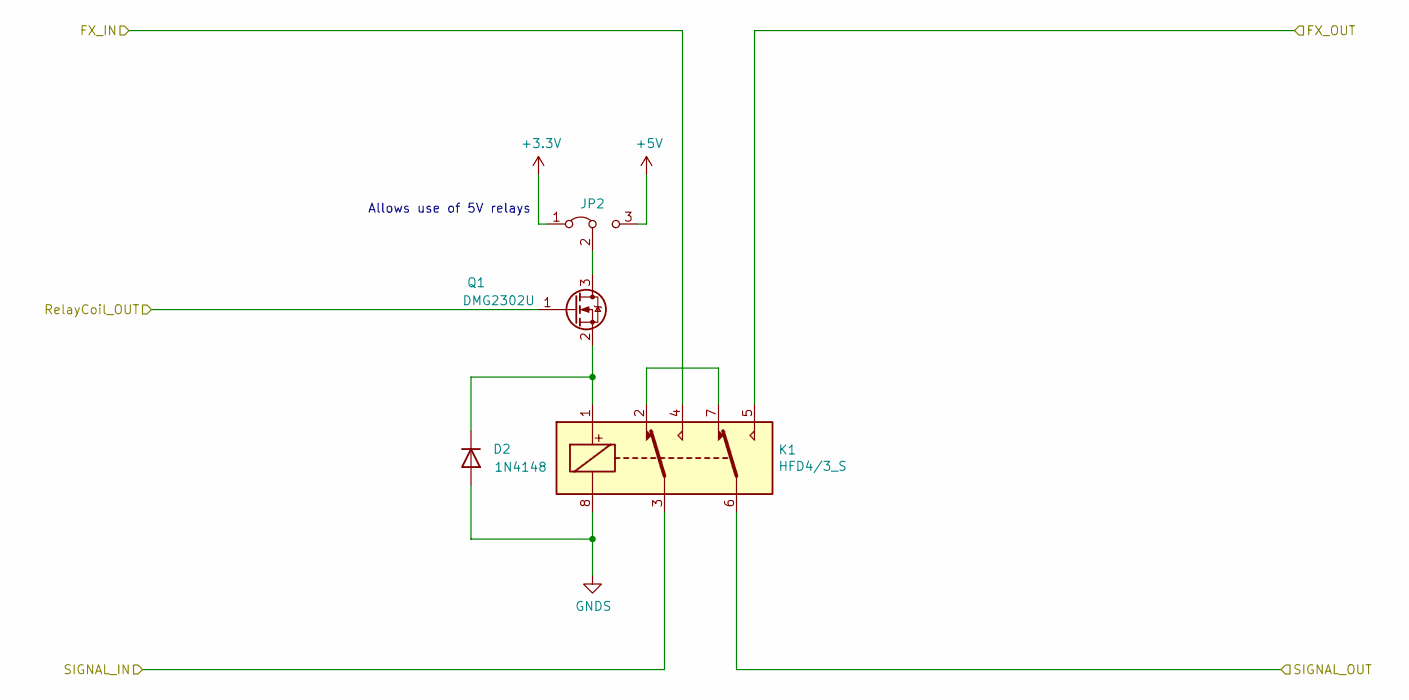
[picture p25: schematic SignalRelay.sch]

Parts:
D2: 1N4148; D_SOD-123F
JP2: Jumper_3_Bridged12; SolderJumper-3_P1.3mm_Bridged2Bar12_Pad1.0x1.5mm
K1: HFD4/3_S; Relay_Fujitsu_FTR-B3S
Q1: DMG2302U; SOT-23

Connections:
+3.3V: JP2.1 (A)
+5V: JP2.3 (B)
FX_IN: K1.4
FX_OUT: K1.5
GNDS: D2.2 (A), K1.8
unnamed: D2.1 (K), K1.1, Q1.2 (S)
unnamed: JP2.2 (C), Q1.3 (D)
unnamed: K1.2, K1.7
RelayCoil_OUT: Q1.1 (G)
SIGNAL_IN: K1.3
SIGNAL_OUT: K1.6

Notes on the sheet:
Allows use of 5V relays
