cracked-machine/CirrusDspPedal/(commit log)

2020-10-11 first draft schema design
    [CirrusDspPedal.kicad_pcb, CirrusDspPedal.sch, InputSignal.sch, OutputSignal.sch, PSU.sch, PowerFiltering.sch, STM32F407_PowerFiltering.sch, STM32F411_PowerFiltering.sch]
2020-10-12 Added Footswitches and relay
    [CirrusDspPedal.sch, ExpInput.sch, ExtInput.sch, InputSignal.sch, OutputSignal.sch, PSU.sch, PowerFiltering.sch, STM32F411_PowerFiltering.sch]
2020-10-18 Added UserPots and RGB LEDS
    Updated schema docs
    [CirrusDspPedal.sch, ExtInput.sch, SignalProcessing.sch]
2020-10-18 Completed schematic design
    [CirrusDspPedal.sch, ExtInput.sch, InputSignal.sch, MicroSD.sch, OutputSignal.sch, PSU.sch, PowerFiltering.sch, STM32F411_PowerFiltering.sch]
2020-10-19 finished RevA layout
    [CirrusDspPedal-B_Cu.gbr, CirrusDspPedal-B_Mask.gbr, CirrusDspPedal-B_Paste.gbr, CirrusDspPedal-B_SilkS.gbr, CirrusDspPedal-Edge_Cuts.gbr, CirrusDspPedal-F_Cu.gbr, CirrusDspPedal-F_Mask.gbr, CirrusDspPedal-F_Paste.gbr]
2020-10-29 updated design and layout
    - Changed LDO to 1703 (footprint unchanged)
    - Changed THT LEDs from RAGB (incorrect) to RCGB (correct) symbol (footprint unchanged)
    [CirrusDspPedal-B_Cu.gbr, CirrusDspPedal-B_Mask.gbr, CirrusDspPedal-B_Paste.gbr, CirrusDspPedal-B_SilkS.gbr, CirrusDspPedal-Edge_Cuts.gbr, CirrusDspPedal-F_Cu.gbr, CirrusDspPedal-F_Mask.gbr, CirrusDspPedal-F_Paste.gbr]
2020-10-29 updated design and layout
    - Changed LDO package from SOT23 to SOT223
    [CirrusDspPedal-B_Cu.gbr, CirrusDspPedal-B_Mask.gbr, CirrusDspPedal-B_Paste.gbr, CirrusDspPedal-B_SilkS.gbr, CirrusDspPedal-Edge_Cuts.gbr, CirrusDspPedal-F_Cu.gbr, CirrusDspPedal-F_Mask.gbr, CirrusDspPedal-F_Paste.gbr]
2020-10-31 Updated design
    - Corrected trace going to wrong CS4344 channel output
    [CirrusDspPedal-B_Cu.gbr, CirrusDspPedal-B_Mask.gbr, CirrusDspPedal-B_Paste.gbr, CirrusDspPedal-B_SilkS.gbr, CirrusDspPedal-Edge_Cuts.gbr, CirrusDspPedal-F_Cu.gbr, CirrusDspPedal-F_Mask.gbr, CirrusDspPedal-F_Paste.gbr]
2020-11-06 finished revb layout
    [CirrusDspPedal-B_Cu.gbr, CirrusDspPedal-B_Mask.gbr, CirrusDspPedal-B_Paste.gbr, CirrusDspPedal-B_SilkS.gbr, CirrusDspPedal-Edge_Cuts.gbr, CirrusDspPedal-F_Cu.gbr, CirrusDspPedal-F_Mask.gbr, CirrusDspPedal-F_Paste.gbr]
2020-11-07 updated revb
    - Added n-chan and 5V/3V3 jumper for relay
    - Moved MCU to the middle of PCB (more space)
    [CirrusDspPedal.kicad_pcb, InputSignal.sch, SignalRelay.sch]
2020-11-07 updated gerbers/schematic docs
    [CirrusDspPedal-B_Cu.gbr, CirrusDspPedal-B_Mask.gbr, CirrusDspPedal-B_Paste.gbr, CirrusDspPedal-B_SilkS.gbr, CirrusDspPedal-Edge_Cuts.gbr, CirrusDspPedal-F_Cu.gbr, CirrusDspPedal-F_Mask.gbr, CirrusDspPedal-F_Paste.gbr]
2020-11-08 replaced SDIO connector
    [CirrusDspPedal-B_Cu.gbr, CirrusDspPedal-B_Mask.gbr, CirrusDspPedal-B_Paste.gbr, CirrusDspPedal-B_SilkS.gbr, CirrusDspPedal-Edge_Cuts.gbr, CirrusDspPedal-F_Cu.gbr, CirrusDspPedal-F_Mask.gbr, CirrusDspPedal-F_Paste.gbr]
2020-11-10 Updated RevB
    - Replaced analog pots with Rotary Encoders
    - Added I2C connector (for OLED screen)
    [475710001.stp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]
2020-11-10 updated revB
    - Added higher out current LDO (LD1117) for 5V rail
    - Added jumper on OLED connector to select 3V3/5V
    [CirrusDspPedal-B_Cu.gbr, CirrusDspPedal-B_Mask.gbr, CirrusDspPedal-B_Paste.gbr, CirrusDspPedal-B_SilkS.gbr, CirrusDspPedal-Edge_Cuts.gbr, CirrusDspPedal-F_Cu.gbr, CirrusDspPedal-F_Mask.gbr, CirrusDspPedal-F_Paste.gbr]
2020-11-10 updated revb
    - Added input amp with charge pump and protection diodes
    [CirrusDspPedal-B_Cu.gbr, CirrusDspPedal-B_Mask.gbr, CirrusDspPedal-B_Paste.gbr, CirrusDspPedal-B_SilkS.gbr, CirrusDspPedal-Edge_Cuts.gbr, CirrusDspPedal-F_Cu.gbr, CirrusDspPedal-F_Mask.gbr, CirrusDspPedal-F_Paste.gbr]
2020-11-12 updated revb
    - Moved THT components to improve UX layout
    [CUI_PJ-102A.STEP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]
2020-11-12 final revb layout
    [CirrusDspPedal-B_Cu.gbr, CirrusDspPedal-B_Mask.gbr, CirrusDspPedal-B_Paste.gbr, CirrusDspPedal-B_SilkS.gbr, CirrusDspPedal-Edge_Cuts.gbr, CirrusDspPedal-F_Cu.gbr, CirrusDspPedal-F_Mask.gbr, CirrusDspPedal-F_Paste.gbr]
2020-11-28 Added second project for front panel: "CirrusDspPedal_FrontPanel"
    No components or traces, edge cuts, silkscreen and top copper pour only
    [475710001.stp, CUI_PJ-102A.STEP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]
2021-01-09 modified front panel
    Raised footswitch holes by 3mm
    [CirrusDspPedal-B_Cu.gbr, CirrusDspPedal-B_Mask.gbr, CirrusDspPedal-B_Paste.gbr, CirrusDspPedal-B_SilkS.gbr, CirrusDspPedal-Edge_Cuts.gbr, CirrusDspPedal-F_Cu.gbr, CirrusDspPedal-F_Mask.gbr, CirrusDspPedal-F_Paste.gbr]
