cracked-machine/CirrusDspPedal/(notices)

Notices in the files:
CirrusDspPedal_FrontPanel/3d/M2012SS1W03.stp:
FILE_NAME( 'p:/temp/worker_245/temp/exporttempdir_5624_3_H4LTu/format_0/M2012SS1W03.stp', '2020-11-11T23:46:59', ( 'License CC BY-ND 4.0' ), ( 'CADENAS' ), ' ', 'PARTsolutions', ' ' );
